erikvanzijst/handheld/README.md

# 8-bit handheld multiplayer gaming device

An Open Source Hardware custom designed handheld gaming device.

* powered by an 8-bit AVR XMEGA microcontroller
* ultra low-res 24x16 monochrome display made of discrete LEDS
* authentic 8-bit retro sound and music
* EEPROM-based hiscores
* multiplayer over bidirectional infrared communication
* battery or USB powered

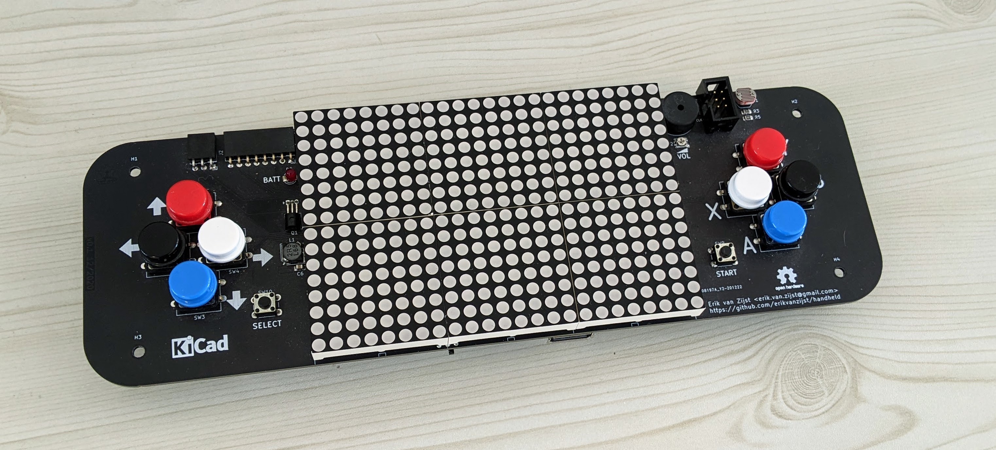
[picture p1: media/device.jpg]
Device


Project write-up at: https://medium.com/@erikvanzijst/diy-8-bit-handheld-multiplayer-gaming-device-cc30baae7372

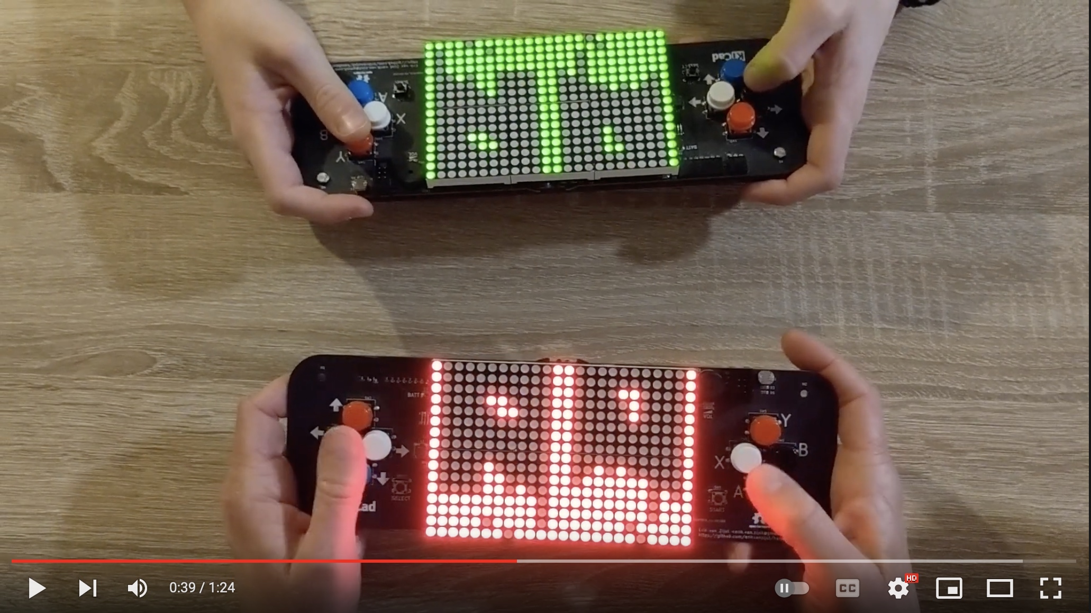
[picture p2: media/yt_thumbnail.jpg]
Multiplayer Tetris video (https://www.youtube.com/watch?v=yx9ZlABf7WM "Watch on Youtube")
