erikvanzijst/handheld/media/kicad_render2.png

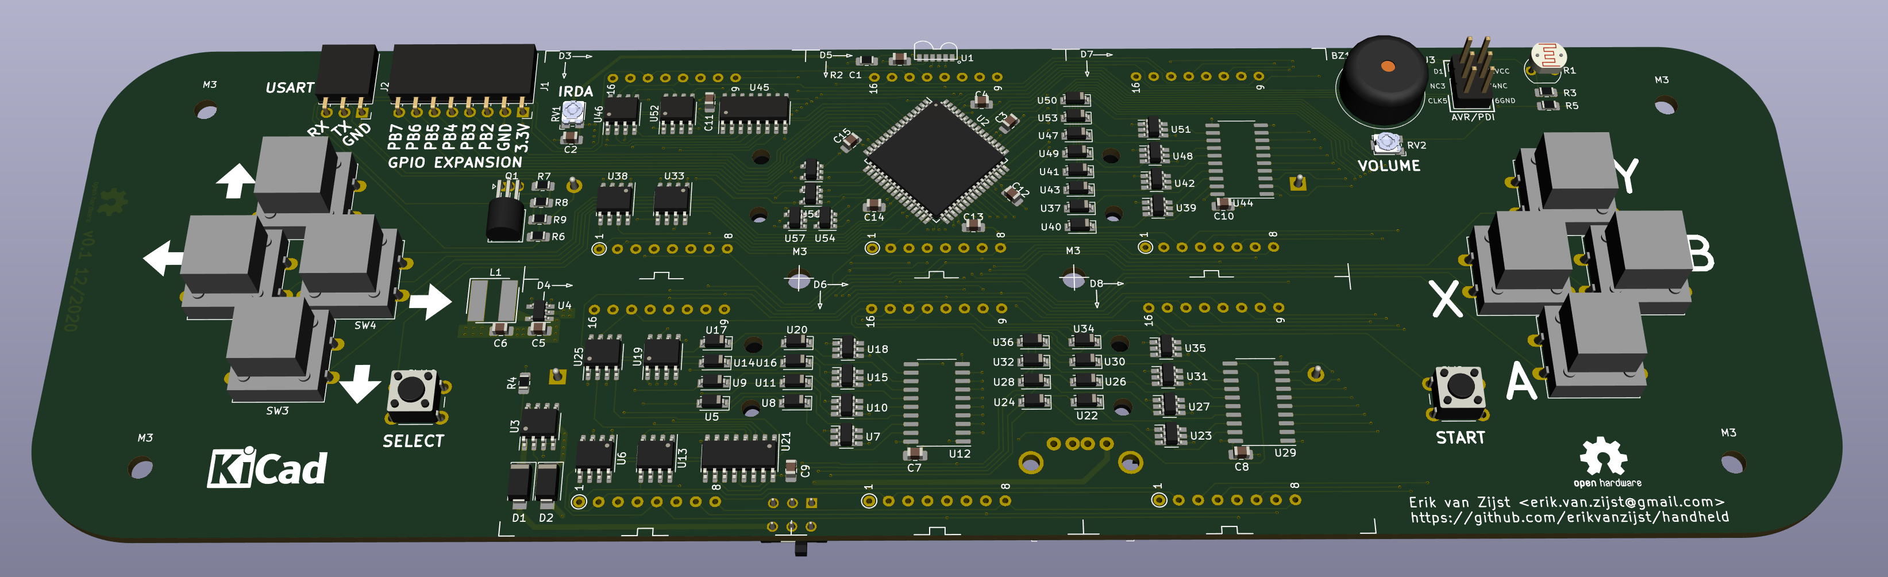
media/kicad_render2.png
