erikvanzijst/handheld/media/layout1.jpg

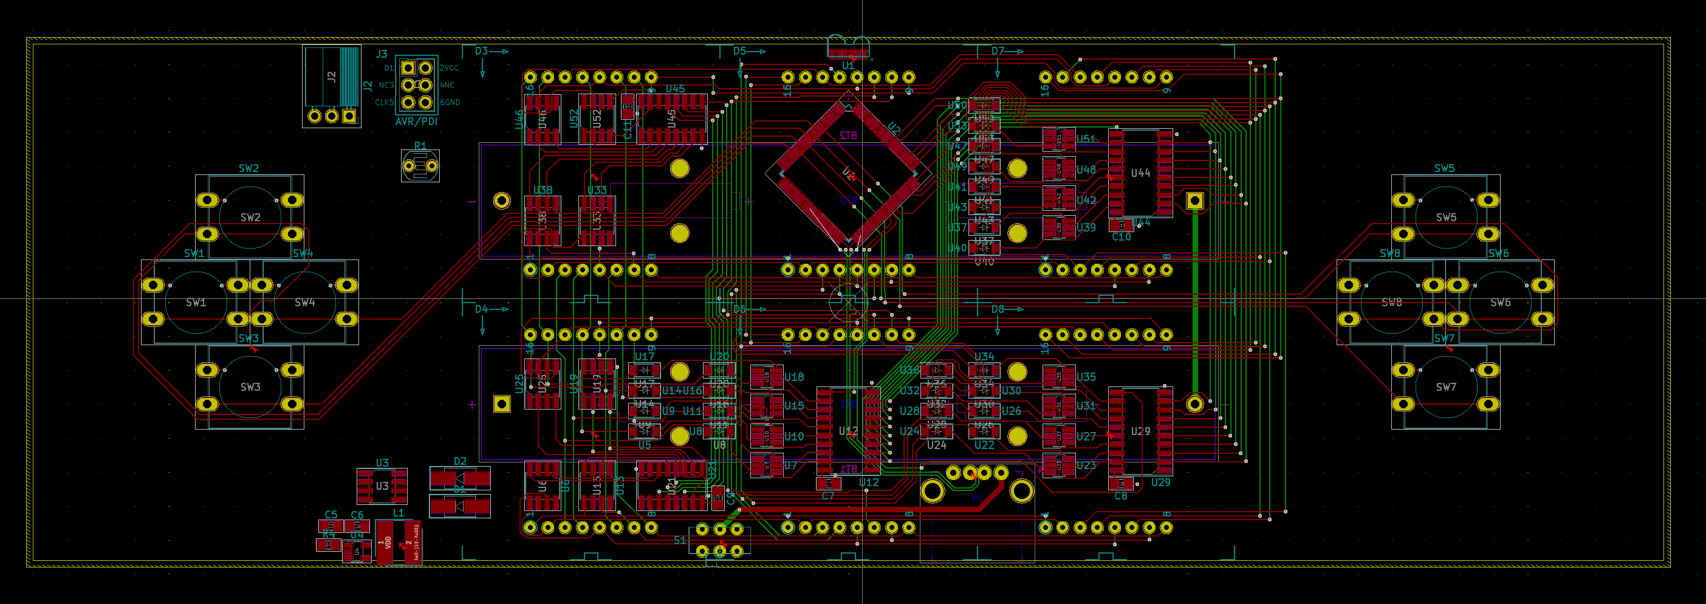
media/layout1.jpg
