erikvanzijst/handheld/media/pulseview_irda.png

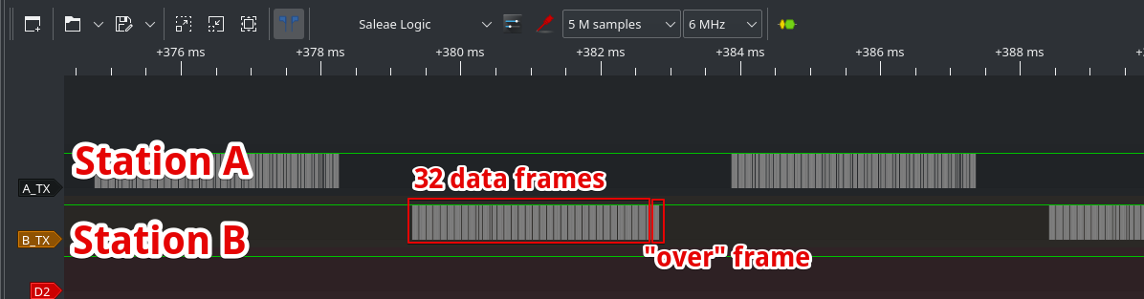
media/pulseview_irda.png
