erikvanzijst/handheld/media/shield1.png

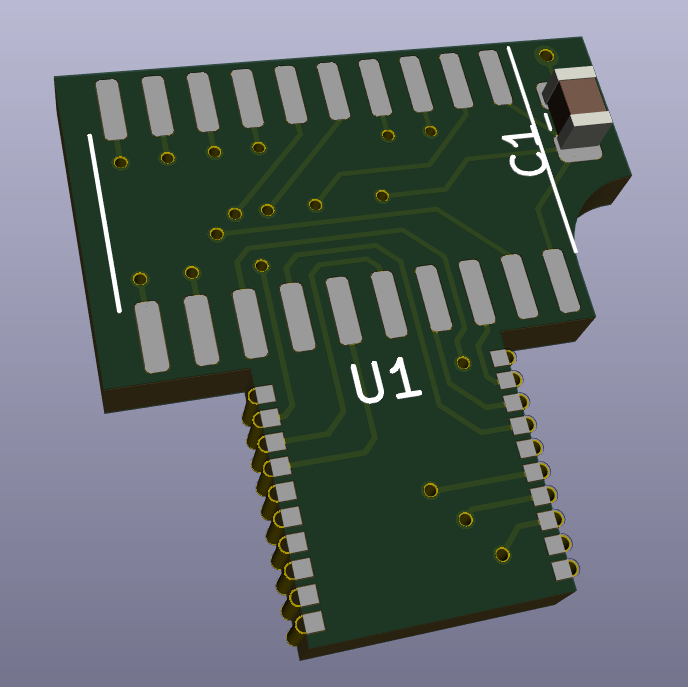
media/shield1.png
