erikvanzijst/handheld/media/short_circuit.jpg

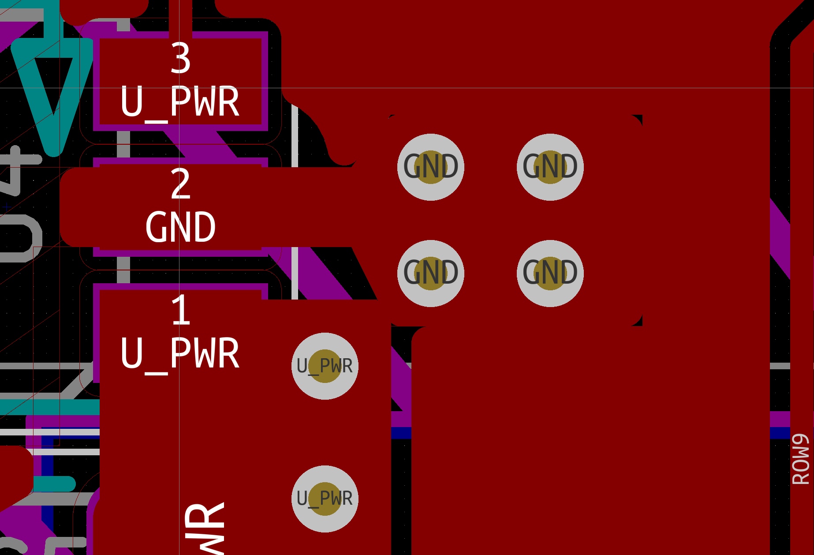
media/short_circuit.jpg
