erikvanzijst/handheld/media/short_circuit_drc.jpg

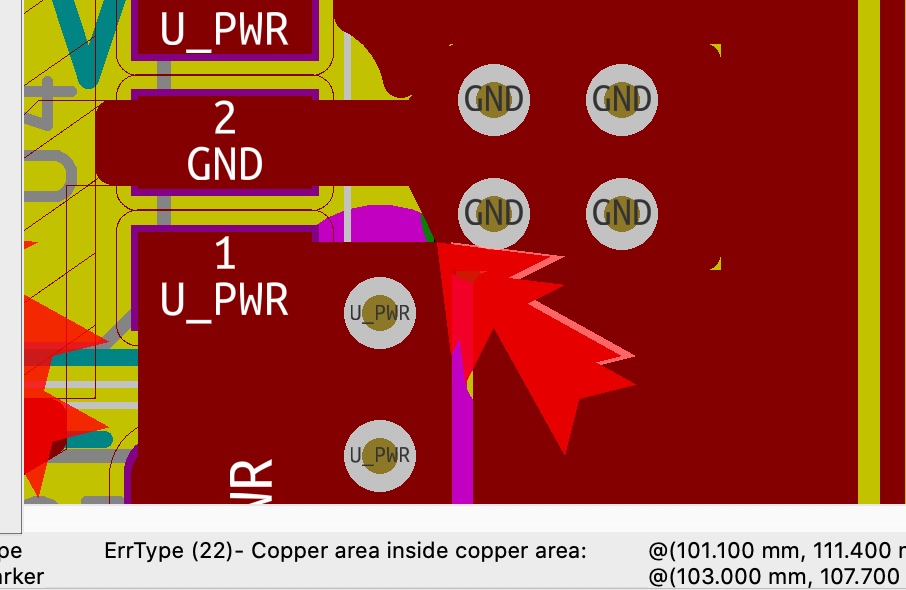
media/short_circuit_drc.jpg
