erikvanzijst/handheld/media/uart_send_loop.jpg

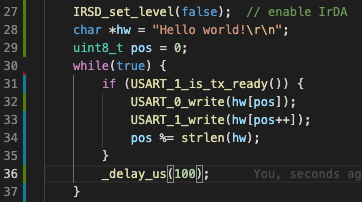
media/uart_send_loop.jpg
