erikvanzijst/handheld/media/uint64_division_asm.png

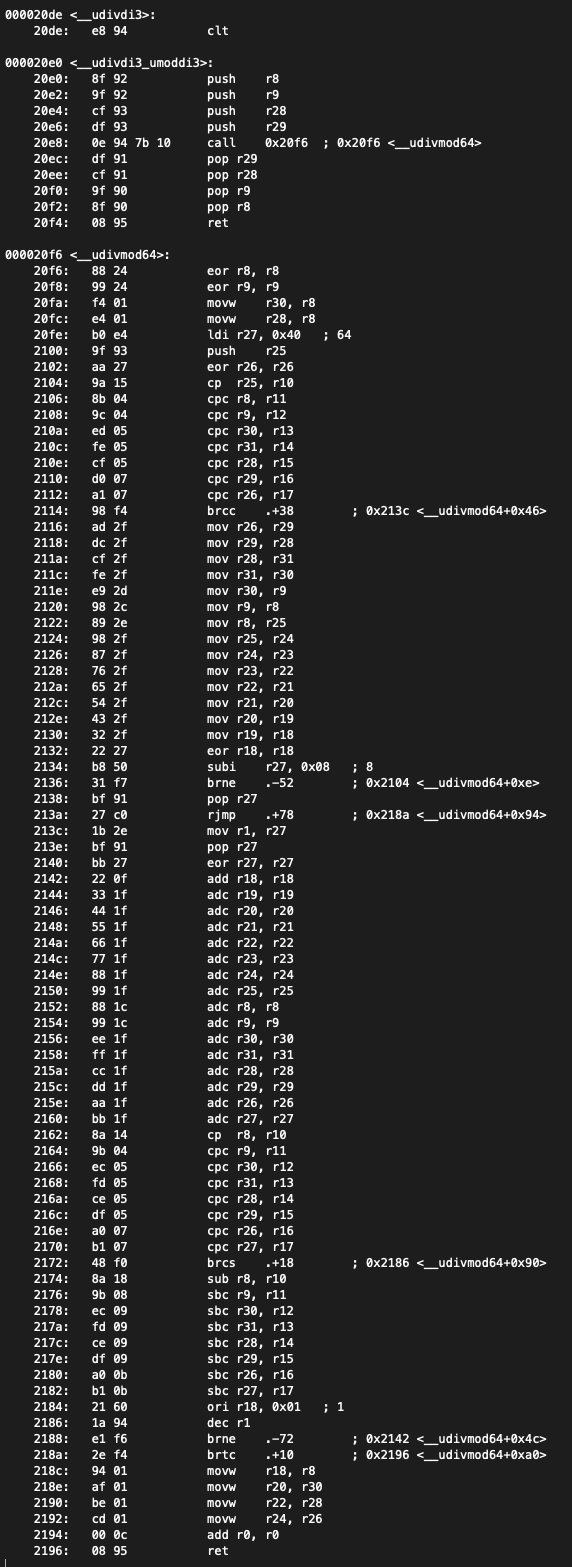
media/uint64_division_asm.png
