erikvanzijst/handheld/media/xmega_ircom.png

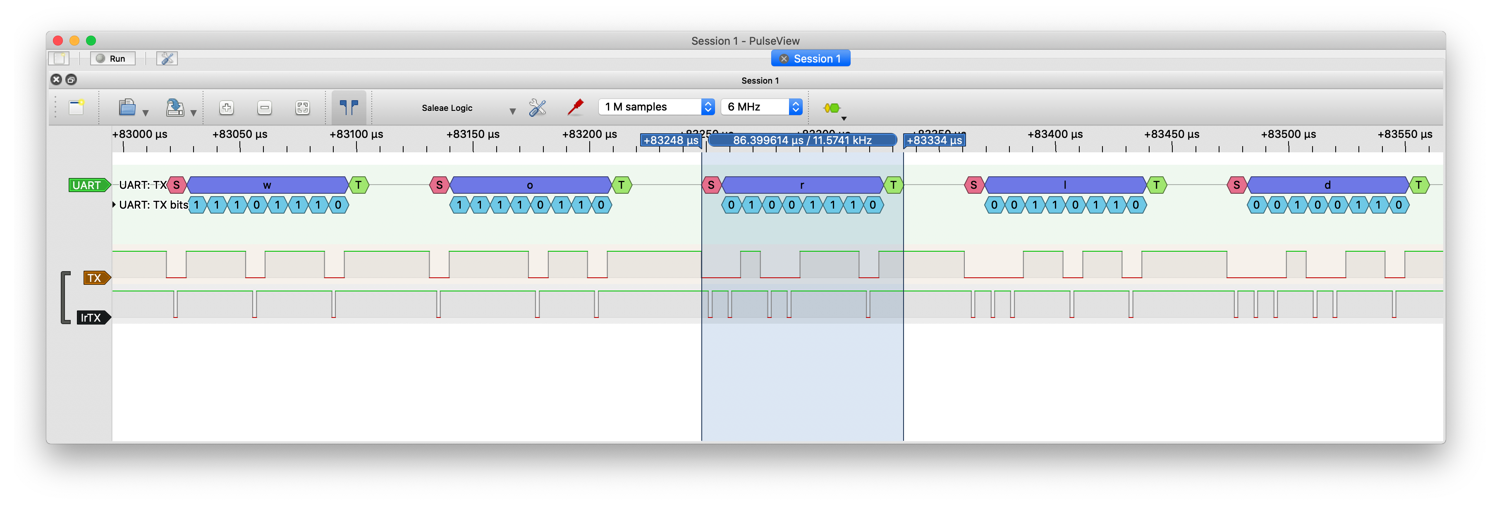
media/xmega_ircom.png
