erikvanzijst/handheld/kicad/TC33X-2-202E--3DModel-STEP-56544.step

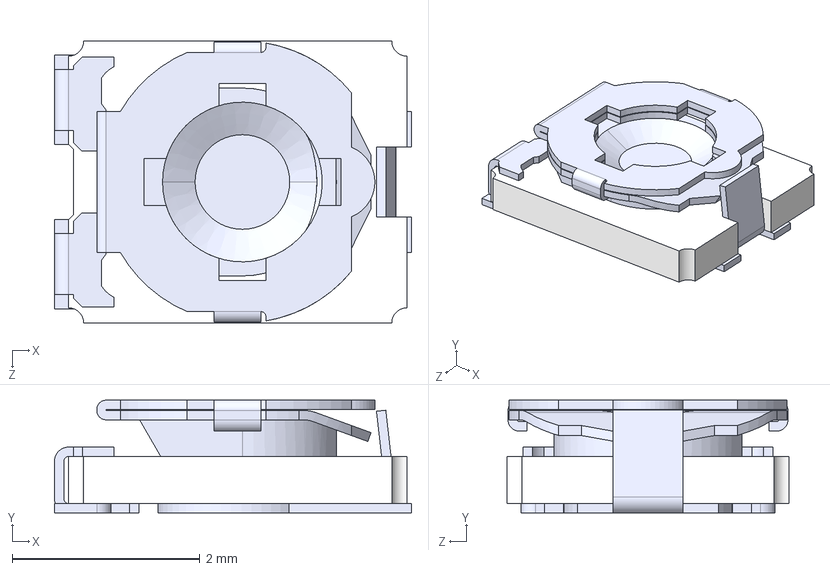
[picture p27: CAD file, 2020-11-29]
kicad/TC33X-2-202E--3DModel-STEP-56544.step
3.80 x 1.20 x 3.00 mm
