erikvanzijst/handheld/kicad/B3F-4055--3DModel-STEP-273799.STEP

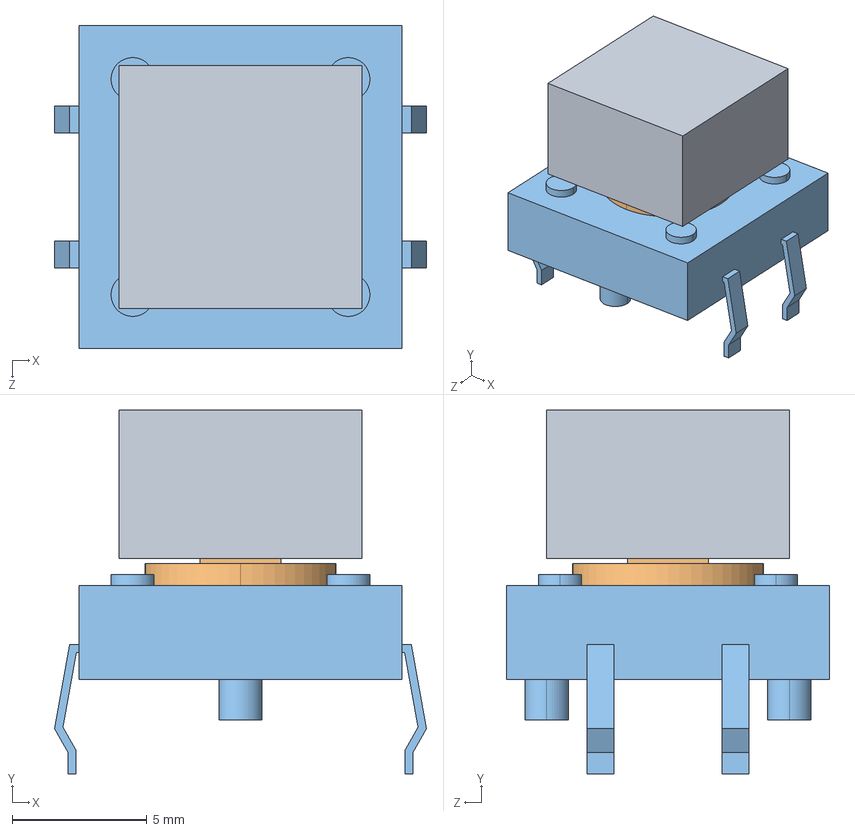
[picture p28: CAD file, 2020-11-28]
kicad/B3F-4055--3DModel-STEP-273799.STEP
13.8 x 13.5 x 12.0 mm
B32_1200
B3F_4055_BUTTON
B3F_4055_BASE
