erikvanzijst/handheld/kicad/TC-33X-2.stp

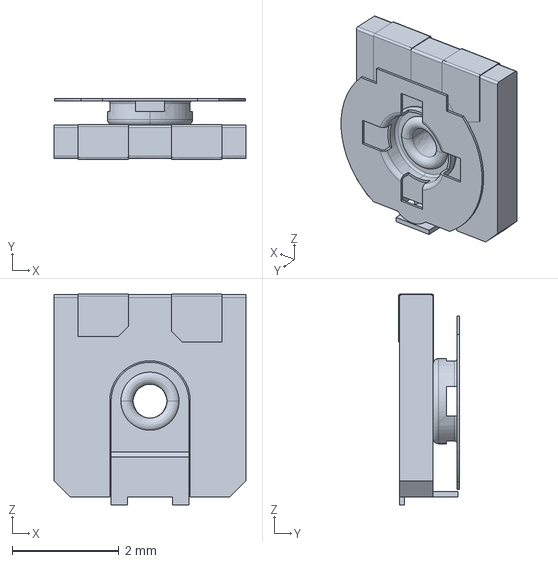
[picture p29: CAD file, 2020-10-12]
kicad/TC-33X-2.stp
3.60 x 1.15 x 3.96 mm
