erikvanzijst/handheld/kicad/84406TFBS4711.stp

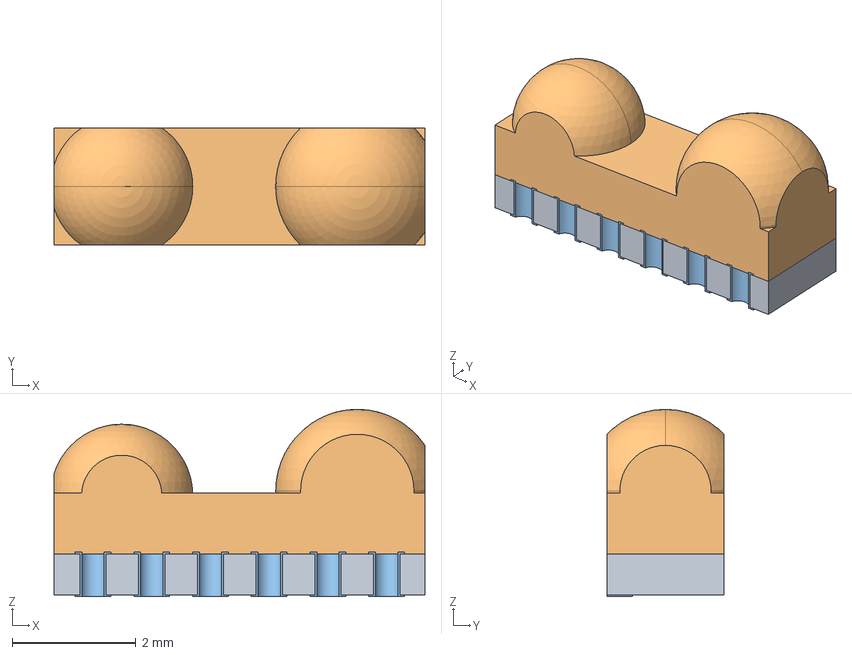
[picture p30: CAD file, 2020-10-13]
kicad/84406TFBS4711.stp
6.00 x 1.90 x 3.03 mm
PLATINE
GEHAEUSE
KONTAKT x 6
