erikvanzijst/handheld/media/irda_logic_analyzer_testing.jpg

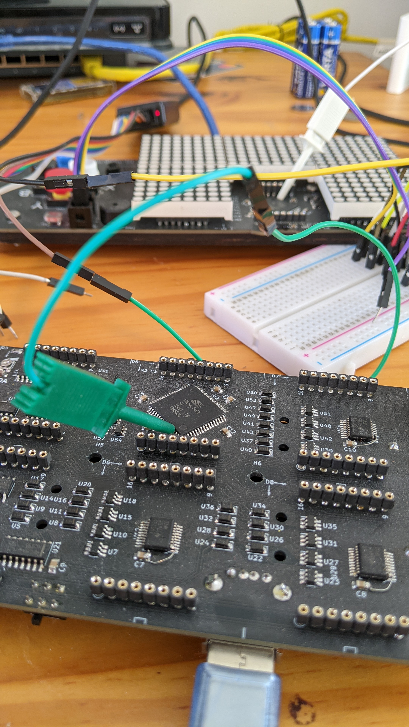
media/irda_logic_analyzer_testing.jpg
