erikvanzijst/handheld/media/irda_uart_testing.png

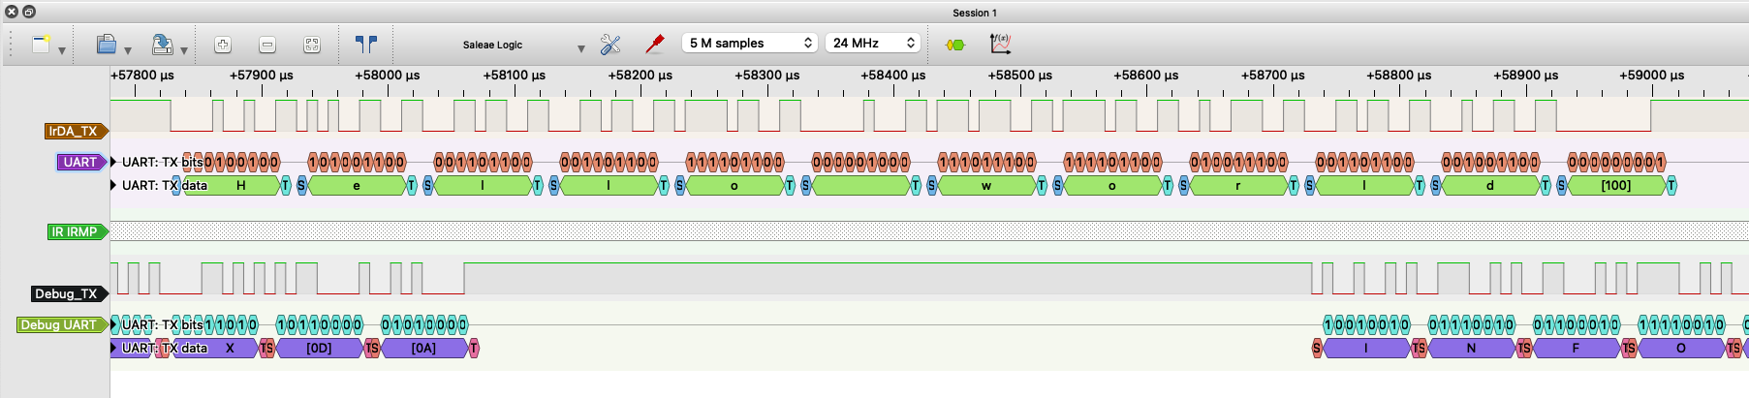
media/irda_uart_testing.png
