erikvanzijst/handheld/kicad/handheld.kicad_pcb

## KiCad design kicad/handheld.kicad_pcb (2021-01-19)

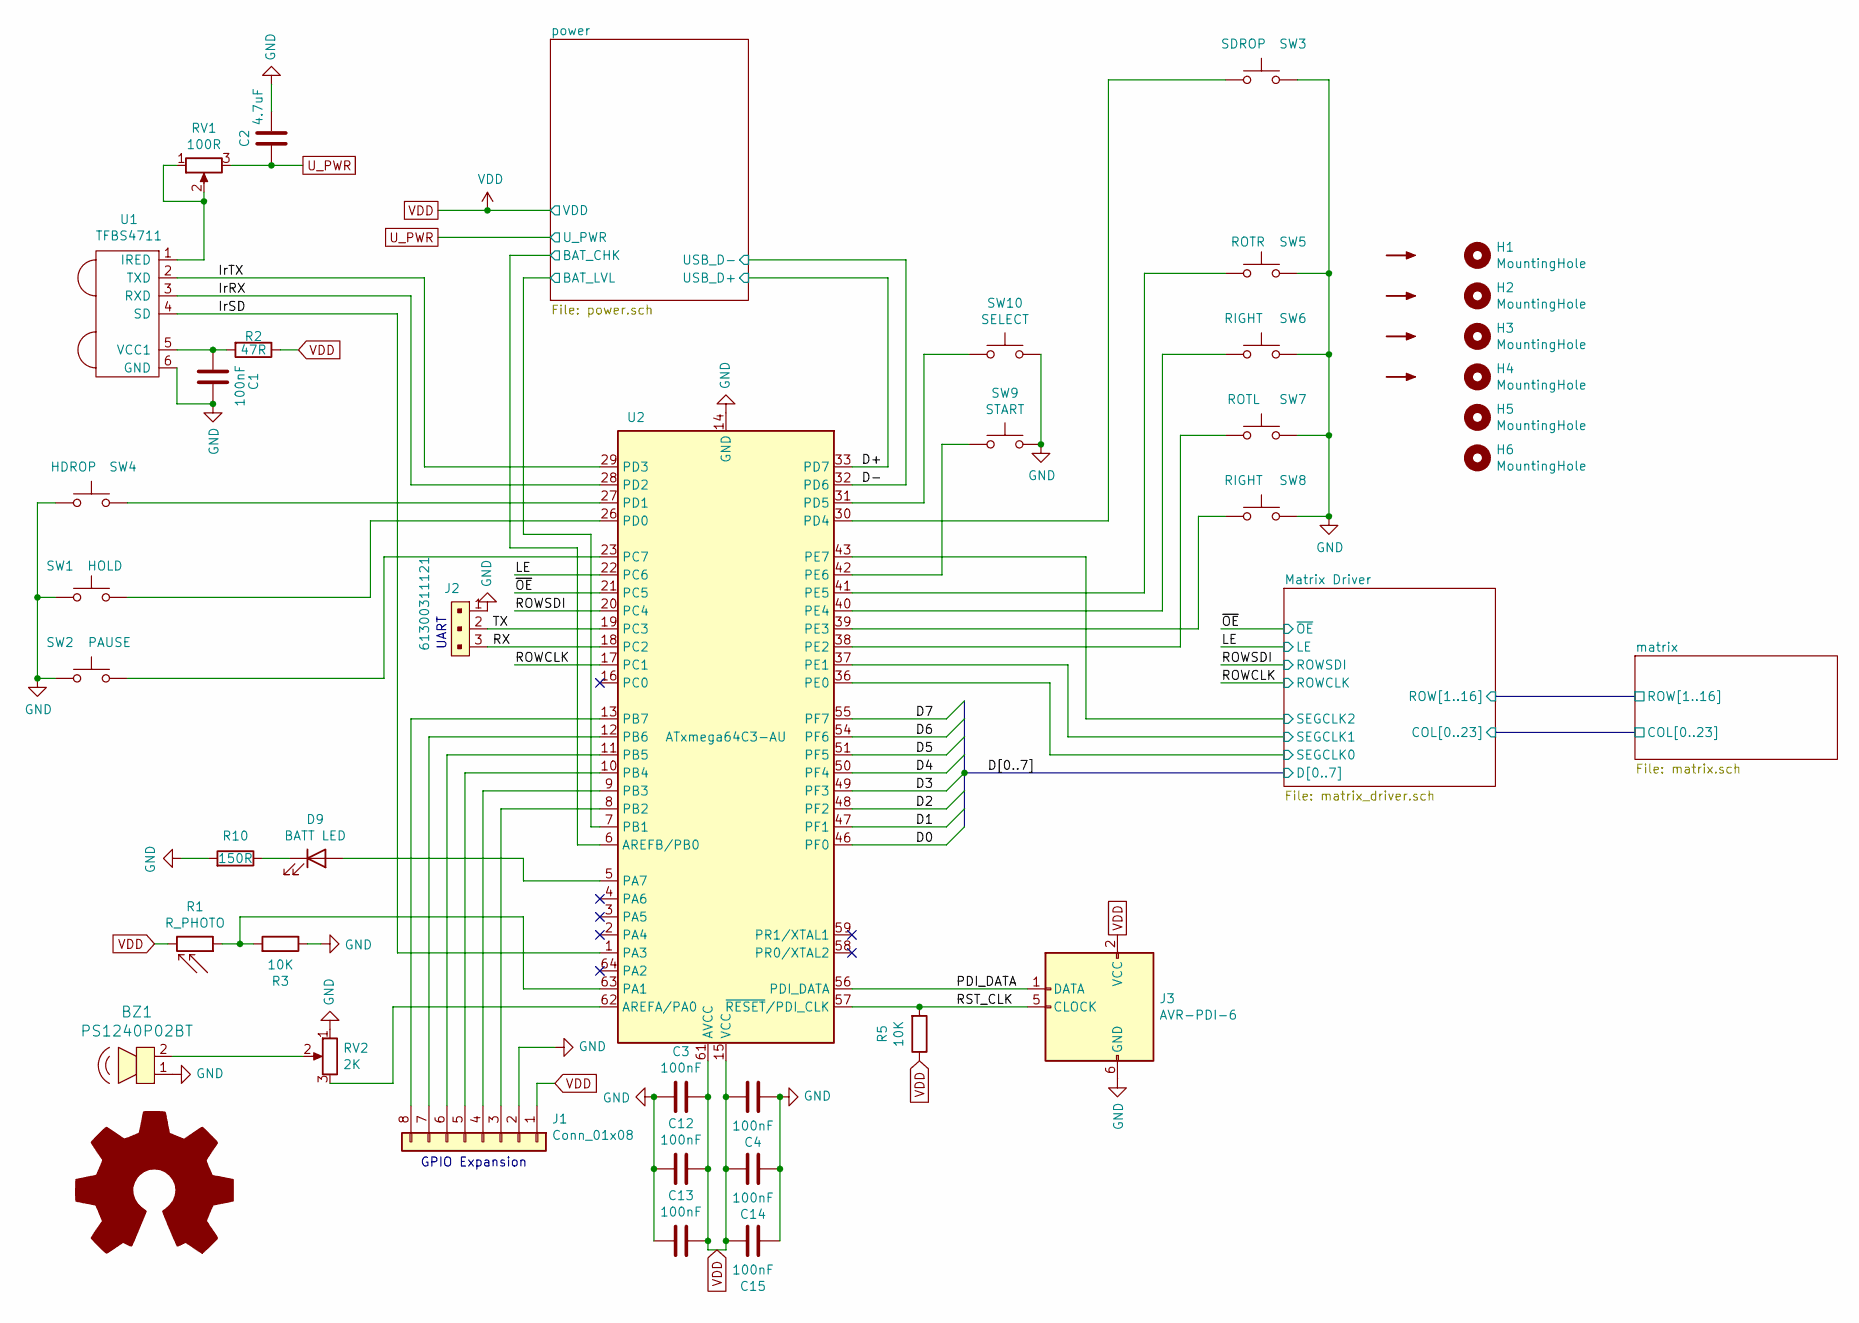
[picture p39: schematic handheld.sch, Handheld gaming device]

Parts:
BZ1: PS1240P02BT; Piezo_Transducer_THT_PS1240P02BT; MPN PS1240P02BT; Digi-Key_PN 445-2525-1-ND
C1, C3, C4, C12, C13, C14, C15: 100nF; C_0805_2012Metric_Pad1.15x1.40mm_HandSolder
C2: 4.7uF; C_0805_2012Metric_Pad1.15x1.40mm_HandSolder
D9: BATT LED; LED_D3.0mm
H1, H2, H3, H4, H5, H6: MountingHole; MountingHole_3.2mm_M3
J1: Conn_01x08; PinSocket_1x08_P2.54mm_Horizontal
J2: 61300311121; PinSocket_1x03_P2.54mm_Horizontal; MPN 61300311121; Digi-Key_PN 732-5316-ND
J3: AVR-PDI-6; AVR_PDI_Header_2x03_P2.54mm_Vertical
R1: R_PHOTO; R_LDR_5.1x4.3mm_P3.4mm_Vertical
R2: 47R; R_0805_2012Metric_Pad1.15x1.40mm_HandSolder
R3, R5: 10K; R_0805_2012Metric_Pad1.15x1.40mm_HandSolder
R10: 150R; R_0805_2012Metric_Pad1.15x1.40mm_HandSolder
RV1: 100R; Potentiometer_Bourns_TC33X_Vertical
RV2: 2K; Potentiometer_Bourns_TC33X_Vertical
SW1: HOLD; SW_PUSH-12mm
SW2: PAUSE; SW_PUSH-12mm
SW3: SDROP; SW_PUSH-12mm
SW4: HDROP; SW_PUSH-12mm
SW5: ROTR; SW_PUSH-12mm
SW6, SW8: RIGHT; SW_PUSH-12mm
SW7: ROTL; SW_PUSH-12mm
SW9: START; SW_PUSH_6mm
SW10: SELECT; SW_PUSH_6mm
U1: TFBS4711; TFBS4711-IrDA
U2: ATxmega64C3-AU; TQFP-64_14x14mm_P0.8mm

Connections:
/D0: U2.46 (PF0); also elsewhere on the board
/D1: U2.47 (PF1); also elsewhere on the board
/D2: U2.48 (PF2); also elsewhere on the board
/D3: U2.49 (PF3); also elsewhere on the board
/D4: U2.50 (PF4); also elsewhere on the board
/D5: U2.51 (PF5); also elsewhere on the board
/D6: U2.54 (PF6); also elsewhere on the board
/D7: U2.55 (PF7); also elsewhere on the board
/D+: U2.33 (PD7); also elsewhere on the board
/D-: U2.32 (PD6); also elsewhere on the board
/IrRX: U1.3 (RXD), U2.28 (PD2)
/IrSD: U1.4 (SD), U2.1 (PA3)
/IrTX: U1.2 (TXD), U2.29 (PD3)
/LE: U2.22 (PC6); also elsewhere on the board
/Matrix Driver/SEGCLK0: U2.36 (PE0); also elsewhere on the board
/Matrix Driver/SEGCLK1: U2.37 (PE1); also elsewhere on the board
/Matrix Driver/SEGCLK2: U2.43 (PE7); also elsewhere on the board
/PDI_DATA: J3.1 (DATA), U2.56 (PDI_DATA)
/ROWCLK: U2.17 (PC1); also elsewhere on the board
/ROWSDI: U2.20 (PC4); also elsewhere on the board
/RST_CLK: J3.5 (CLOCK), R5.2, U2.57 (~RESET~/PDI_CLK)
/RX: J2.3, U2.18 (PC2)
/TX: J2.2, U2.19 (PC3)
/power/BAT_CHK: U2.6 (AREFB/PB0); also elsewhere on the board
/power/BAT_LVL: U2.7 (PB1); also elsewhere on the board
/~OE: U2.21 (PC5); also elsewhere on the board
GND: BZ1.1, C1.1, C2.2, C3.2, C4.2, C12.2, C13.2, C14.2, C15.2, J1.2, J2.1, J3.6 (GND), R3.1, R10.2, RV2.1, SW1.1, SW2.1, SW3.1, SW4.2, SW5.1, SW6.1, SW7.1, SW8.1, SW9.2, SW10.2, U1.6 (GND), U2.14 (GND), U2.24 (GND), U2.34 (GND), U2.44 (GND), U2.52 (GND), U2.60 (GND); also elsewhere on the board
unnamed: BZ1.2, RV2.2
unnamed: C1.2, R2.2, U1.5 (VCC1)
unnamed: D9.1 (K), R10.1
unnamed: D9.2 (A), U2.5 (PA7)
unnamed: J1.3, U2.8 (PB2)
unnamed: J1.4, U2.9 (PB3)
unnamed: J1.5, U2.10 (PB4)
unnamed: J1.6, U2.11 (PB5)
unnamed: J1.7, U2.12 (PB6)
unnamed: J1.8, U2.13 (PB7)
unnamed: R1.1, R3.2, U2.63 (PA1)
unnamed: RV1.1, RV1.2, U1.1 (IRED)
unnamed: RV2.3, U2.62 (AREFA/PA0)
unnamed: SW1.2, U2.26 (PD0)
unnamed: SW2.2, U2.23 (PC7)
unnamed: SW3.2, U2.30 (PD4)
unnamed: SW4.1, U2.27 (PD1)
unnamed: SW5.2, U2.41 (PE5)
unnamed: SW6.2, U2.40 (PE4)
unnamed: SW7.2, U2.38 (PE2)
unnamed: SW8.2, U2.39 (PE3)
unnamed: SW9.1, U2.42 (PE6)
unnamed: SW10.1, U2.31 (PD5)
U_PWR: C2.1, RV1.3; also elsewhere on the board
VDD: C3.1, C4.1, C12.1, C13.1, C14.1, C15.1, J1.1, J3.2 (VCC), R1.2, R2.1, R5.1, U2.15 (VCC), U2.25 (VCC), U2.35 (VCC), U2.45 (VCC), U2.53 (VCC), U2.61 (AVCC); also elsewhere on the board

Notes on the sheet:
UART
GPIO Expansion

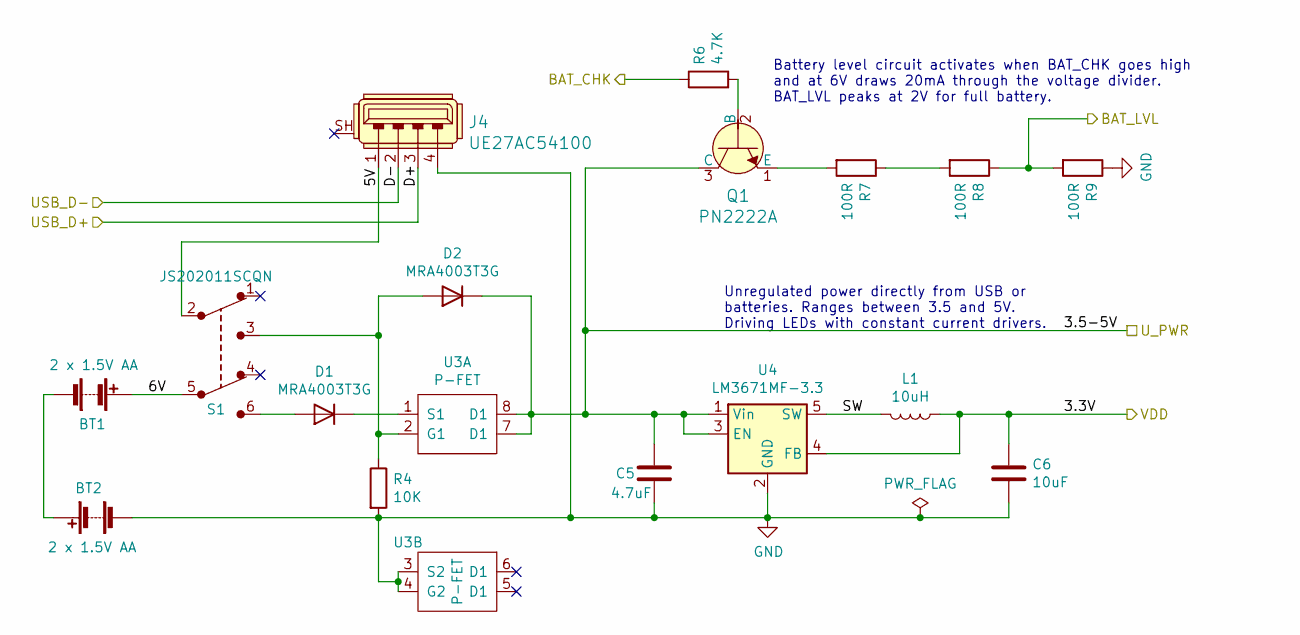
[picture p40: schematic power.sch]

Parts:
BT1, BT2: 2 x 1.5V AA; BatteryHolder_MPD_BC12AAPC_2xAA
C5: 4.7uF; C_0805_2012Metric_Pad1.15x1.40mm_HandSolder
C6: 10uF; C_0805_2012Metric_Pad1.15x1.40mm_HandSolder
D1, D2: MRA4003T3G; D_SMA
J4: UE27AC54100; USB_A_Female_UE27AC54100; MPN UE27AC54100; Digi-Key_PN UE27AC54100-ND
L1: 10uH; CDRH5D18NP
Q1: PN2222A; TO-92_Inline_W4.0mm_Horizontal_FlatSideDown; MPN PN2222A; Digi-Key_PN PN2222ACS-ND
R4: 10K; R_0805_2012Metric_Pad1.15x1.40mm_HandSolder
R6: 4.7K; R_0805_2012Metric_Pad1.15x1.40mm_HandSolder
R7, R8, R9: 100R; R_0805_2012Metric_Pad1.15x1.40mm_HandSolder
S1: JS202011SCQN; SW_CuK_JS202011AQN_DPDT_Angled; MPN JS202011SCQN; Digi-Key_PN 401-2002-1-ND
U3: P-FET; SOIC-8_3.9x4.9mm_P1.27mm
U4: LM3671MF-3.3; TSOT-23-5

Connections:
/D+: J4.3; also elsewhere on the board
/D-: J4.2; also elsewhere on the board
/power/5V: J4.1, S1.2
/power/6V: BT1.1 (+), S1.5
/power/BAT_CHK: R6.1; also elsewhere on the board
/power/BAT_LVL: R8.1, R9.2; also elsewhere on the board
/power/SW: L1.2, U4.5 (SW)
GND: BT2.2 (-), C5.2, C6.2, J4.4, R4.2, R9.1, U3.3 (S2), U3.4 (G2), U4.2 (GND); also elsewhere on the board
unnamed: BT1.2 (-), BT2.1 (+)
unnamed: D1.1 (K), U3.1 (S1)
unnamed: D1.2 (A), S1.6
unnamed: D2.2 (A), R4.1, S1.3, U3.2 (G1)
unnamed: Q1.1 (E), R7.2
unnamed: Q1.2 (B), R6.2
unnamed: R7.1, R8.2
U_PWR: C5.1, D2.1 (K), Q1.3 (C), U3.7 (D1), U3.8 (D1), U4.1 (Vin), U4.3 (EN); also elsewhere on the board
VDD: C6.1, L1.1, U4.4 (FB); also elsewhere on the board

Notes on the sheet:
Unregulated power directly from USB or batteries. Ranges between 3.5 and 5V. Driving LEDs with constant current drivers.
Battery level circuit activates when BAT_CHK goes high and at 6V draws 20mA through the voltage divider. BAT_LVL peaks at 2V for full battery.

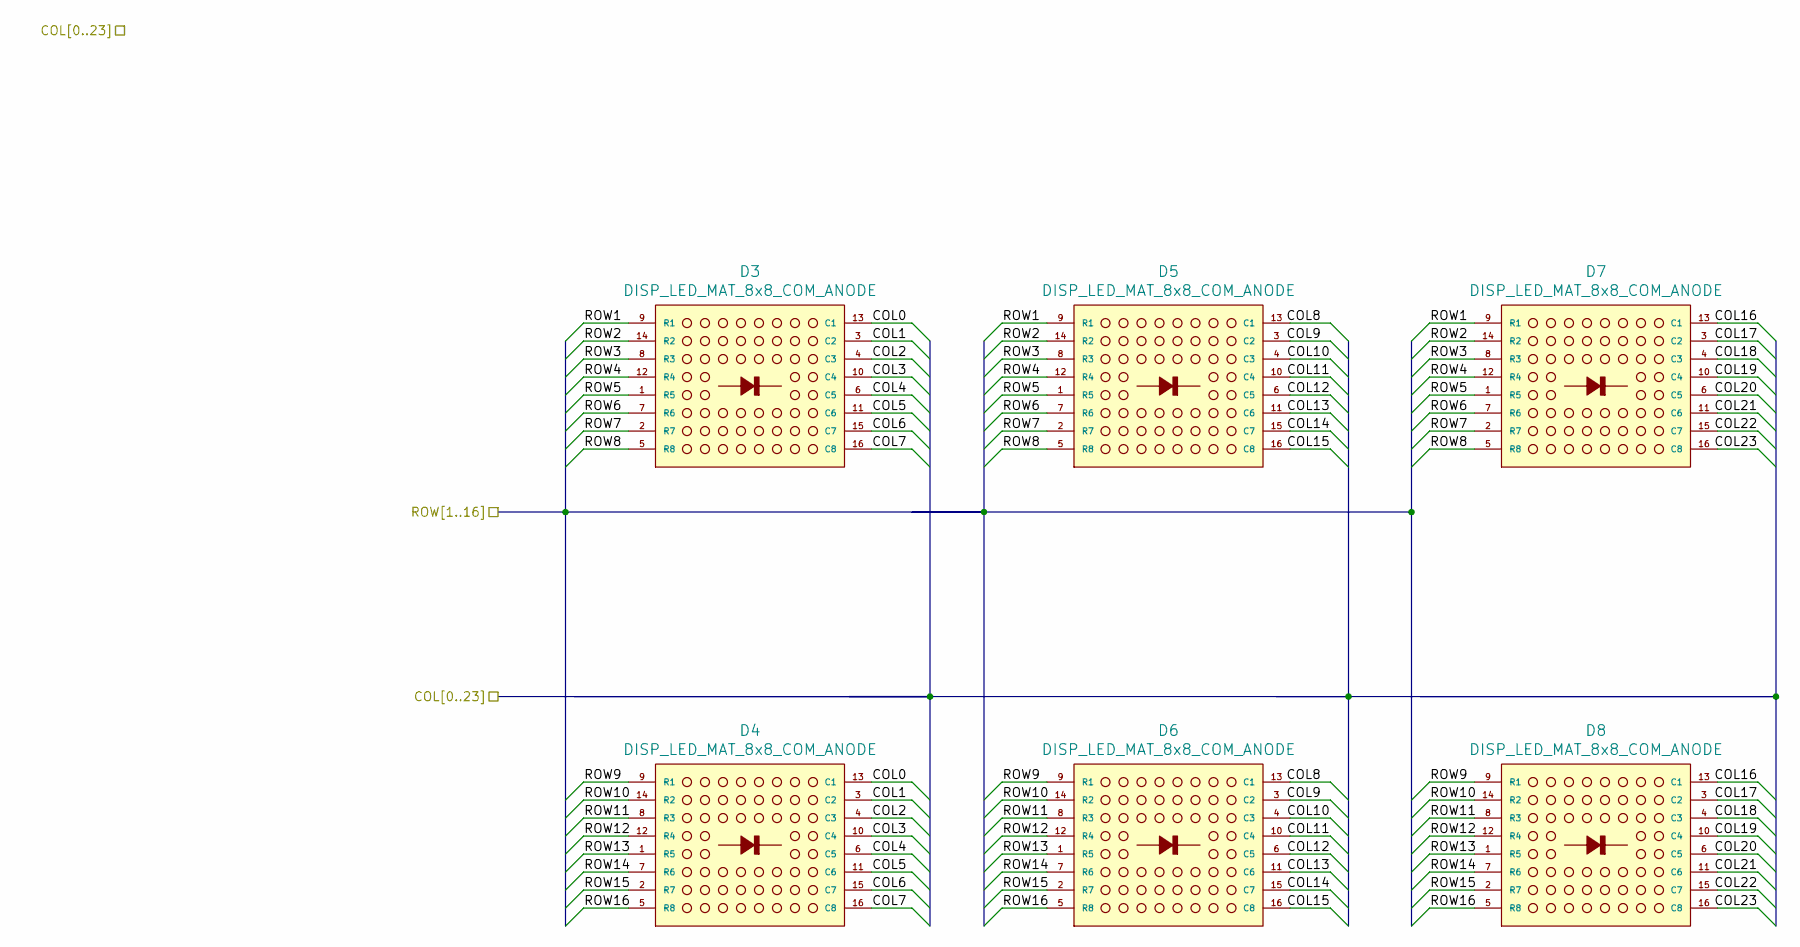
[picture p41: schematic matrix.sch]

Parts:
D3, D4, D5, D6, D7, D8: DISP_LED_MAT_8x8_COM_ANODE; LED_8x8_3MM_38x38MM

Connections:
/Matrix Driver/COL0: D3.13 (C1), D4.13 (C1); also elsewhere on the board
/Matrix Driver/COL1: D3.3 (C2), D4.3 (C2); also elsewhere on the board
/Matrix Driver/COL2: D3.4 (C3), D4.4 (C3); also elsewhere on the board
/Matrix Driver/COL3: D3.10 (C4), D4.10 (C4); also elsewhere on the board
/Matrix Driver/COL4: D3.6 (C5), D4.6 (C5); also elsewhere on the board
/Matrix Driver/COL5: D3.11 (C6), D4.11 (C6); also elsewhere on the board
/Matrix Driver/COL6: D3.15 (C7), D4.15 (C7); also elsewhere on the board
/Matrix Driver/COL7: D3.16 (C8), D4.16 (C8); also elsewhere on the board
/Matrix Driver/COL8: D5.13 (C1), D6.13 (C1); also elsewhere on the board
/Matrix Driver/COL9: D5.3 (C2), D6.3 (C2); also elsewhere on the board
/Matrix Driver/COL10: D5.4 (C3), D6.4 (C3); also elsewhere on the board
/Matrix Driver/COL11: D5.10 (C4), D6.10 (C4); also elsewhere on the board
/Matrix Driver/COL12: D5.6 (C5), D6.6 (C5); also elsewhere on the board
/Matrix Driver/COL13: D5.11 (C6), D6.11 (C6); also elsewhere on the board
/Matrix Driver/COL14: D5.15 (C7), D6.15 (C7); also elsewhere on the board
/Matrix Driver/COL15: D5.16 (C8), D6.16 (C8); also elsewhere on the board
/Matrix Driver/COL16: D7.13 (C1), D8.13 (C1); also elsewhere on the board
/Matrix Driver/COL17: D7.3 (C2), D8.3 (C2); also elsewhere on the board
/Matrix Driver/COL18: D7.4 (C3), D8.4 (C3); also elsewhere on the board
/Matrix Driver/COL19: D7.10 (C4), D8.10 (C4); also elsewhere on the board
/Matrix Driver/COL20: D7.6 (C5), D8.6 (C5); also elsewhere on the board
/Matrix Driver/COL21: D7.11 (C6), D8.11 (C6); also elsewhere on the board
/Matrix Driver/COL22: D7.15 (C7), D8.15 (C7); also elsewhere on the board
/Matrix Driver/COL23: D7.16 (C8), D8.16 (C8); also elsewhere on the board
/Matrix Driver/ROW1: D3.9 (R1), D5.9 (R1), D7.9 (R1); also elsewhere on the board
/Matrix Driver/ROW2: D3.14 (R2), D5.14 (R2), D7.14 (R2); also elsewhere on the board
/Matrix Driver/ROW3: D3.8 (R3), D5.8 (R3), D7.8 (R3); also elsewhere on the board
/Matrix Driver/ROW4: D3.12 (R4), D5.12 (R4), D7.12 (R4); also elsewhere on the board
/Matrix Driver/ROW5: D3.1 (R5), D5.1 (R5), D7.1 (R5); also elsewhere on the board
/Matrix Driver/ROW6: D3.7 (R6), D5.7 (R6), D7.7 (R6); also elsewhere on the board
/Matrix Driver/ROW7: D3.2 (R7), D5.2 (R7), D7.2 (R7); also elsewhere on the board
/Matrix Driver/ROW8: D3.5 (R8), D5.5 (R8), D7.5 (R8); also elsewhere on the board
/Matrix Driver/ROW9: D4.9 (R1), D6.9 (R1), D8.9 (R1); also elsewhere on the board
/Matrix Driver/ROW10: D4.14 (R2), D6.14 (R2), D8.14 (R2); also elsewhere on the board
/Matrix Driver/ROW11: D4.8 (R3), D6.8 (R3), D8.8 (R3); also elsewhere on the board
/Matrix Driver/ROW12: D4.12 (R4), D6.12 (R4), D8.12 (R4); also elsewhere on the board
/Matrix Driver/ROW13: D4.1 (R5), D6.1 (R5), D8.1 (R5); also elsewhere on the board
/Matrix Driver/ROW14: D4.7 (R6), D6.7 (R6), D8.7 (R6); also elsewhere on the board
/Matrix Driver/ROW15: D4.2 (R7), D6.2 (R7), D8.2 (R7); also elsewhere on the board
/Matrix Driver/ROW16: D4.5 (R8), D6.5 (R8), D8.5 (R8); also elsewhere on the board

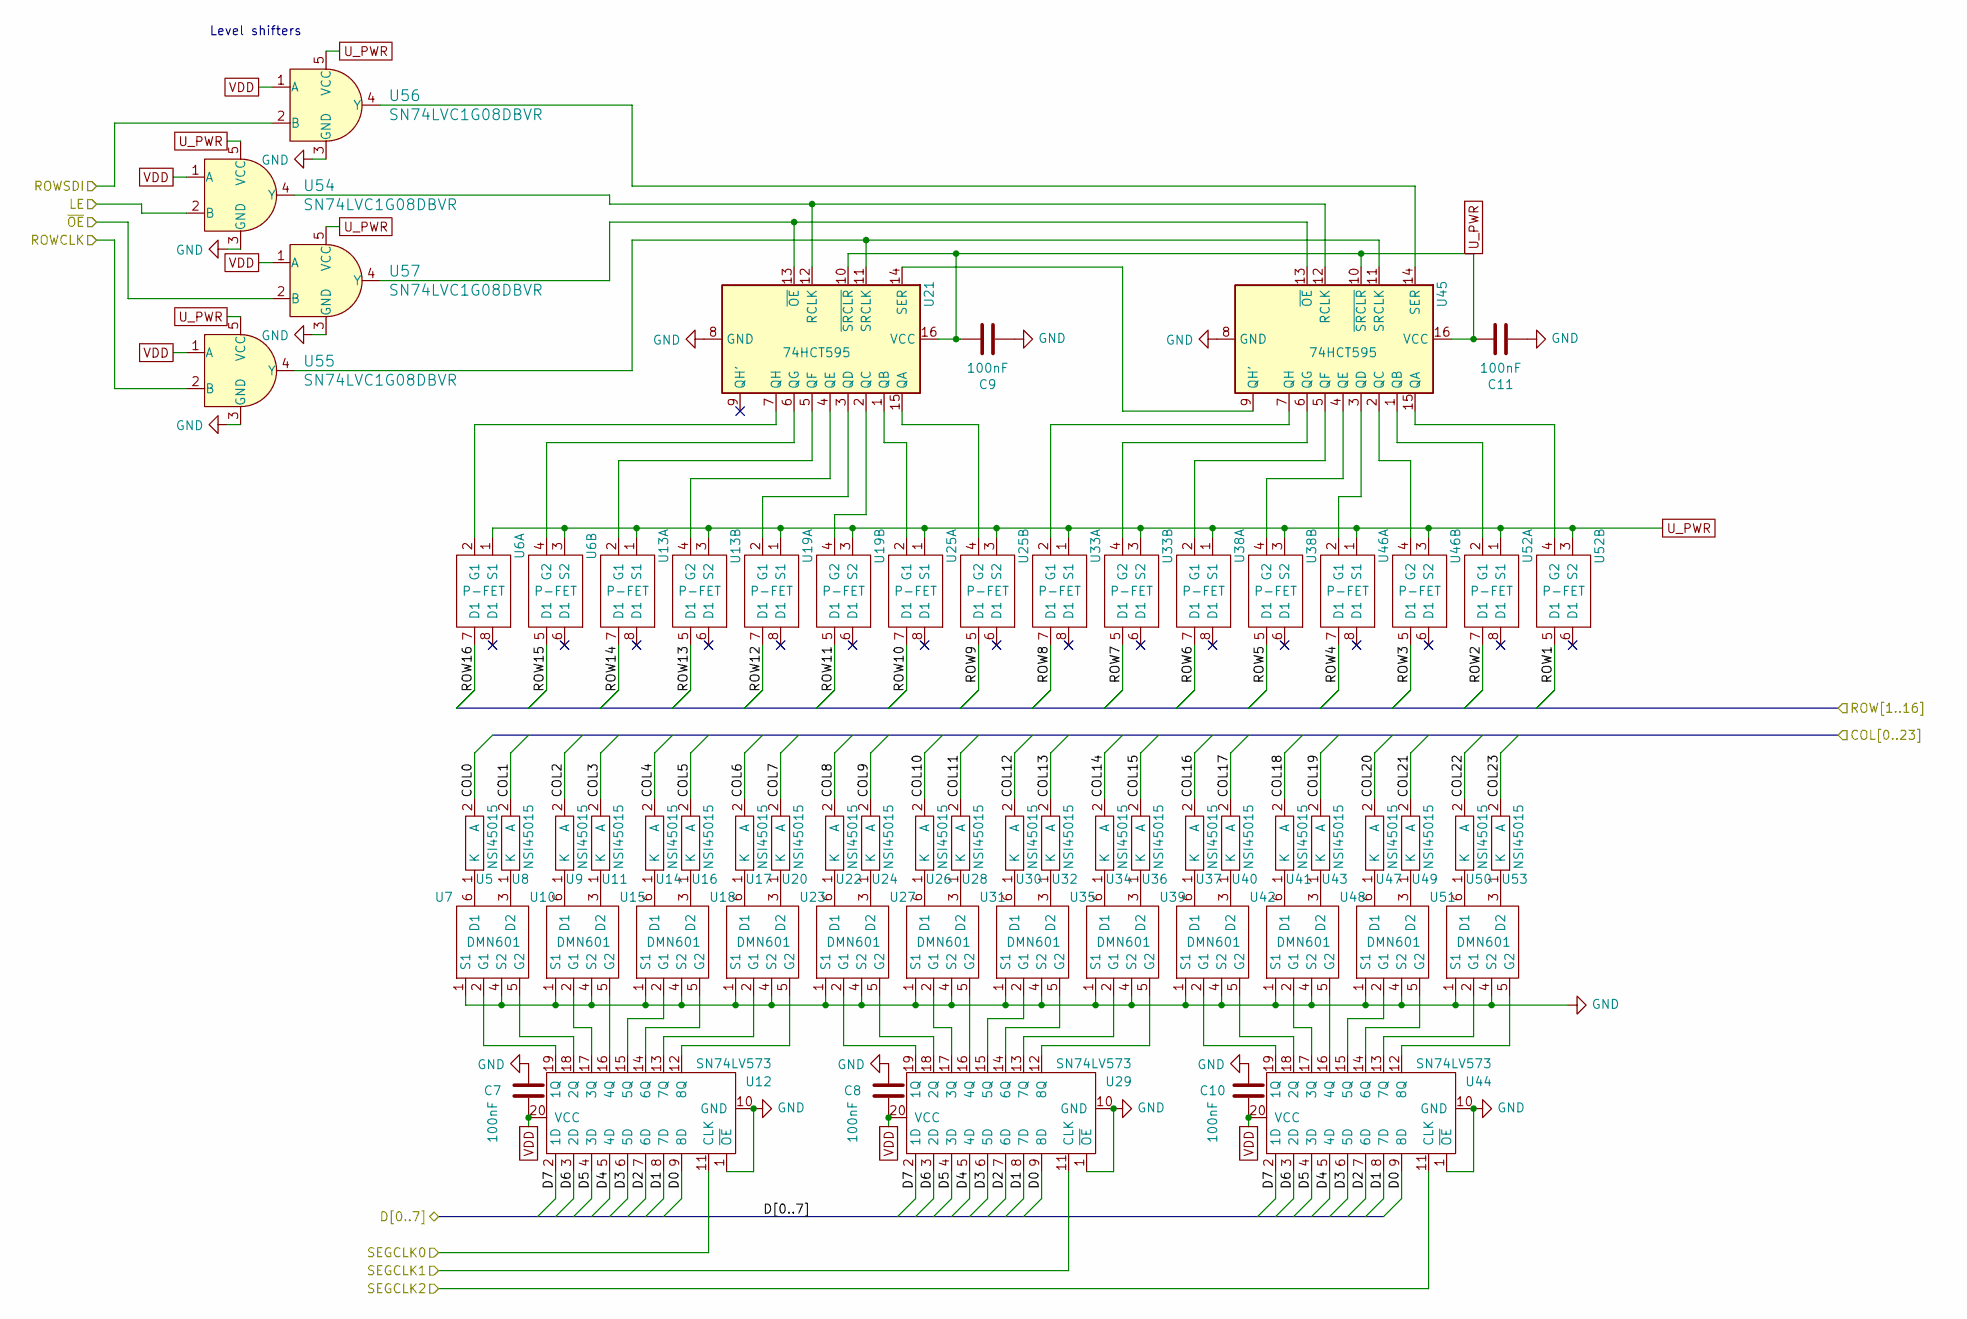
[picture p42: schematic matrix_driver.sch, Matrix driver circuit]

Parts:
C7, C8, C9, C10, C11: 100nF; C_0805_2012Metric_Pad1.15x1.40mm_HandSolder
U5, U8, U9, U11, U14, U16, U17, U20, U22, U24, U26, U28, U30, U32, U34, U36, U37, U40, U41, U43, U47, U49, U50, U53: NSI45015; D_SOD-123
U6, U13, U19, U25, U33, U38, U46, U52: P-FET; SOIC-8_3.9x4.9mm_P1.27mm
U7, U10, U15, U18, U23, U27, U31, U35, U39, U42, U48, U51: DMN601; SOT-23-6_Handsoldering
U12, U29, U44: SN74LV573; SO-20_5.3x12.6mm_P1.27mm
U21, U45: 74HCT595; SOIC-16_3.9x9.9mm_P1.27mm
U54, U55, U56, U57: SN74LVC1G08DBVR; SOT-23-5; MPN SN74LVC1G08DBVR; Digi-Key_PN 296-11601-1-ND

Connections:
/D0: U12.9 (8D), U29.9 (8D), U44.9 (8D); also elsewhere on the board
/D1: U12.8 (7D), U29.8 (7D), U44.8 (7D); also elsewhere on the board
/D2: U12.7 (6D), U29.7 (6D), U44.7 (6D); also elsewhere on the board
/D3: U12.6 (5D), U29.6 (5D), U44.6 (5D); also elsewhere on the board
/D4: U12.5 (4D), U29.5 (4D), U44.5 (4D); also elsewhere on the board
/D5: U12.4 (3D), U29.4 (3D), U44.4 (3D); also elsewhere on the board
/D6: U12.3 (2D), U29.3 (2D), U44.3 (2D); also elsewhere on the board
/D7: U12.2 (1D), U29.2 (1D), U44.2 (1D); also elsewhere on the board
/LE: U54.2 (B); also elsewhere on the board
/Matrix Driver/COL0: U5.2 (A); also elsewhere on the board
/Matrix Driver/COL1: U8.2 (A); also elsewhere on the board
/Matrix Driver/COL2: U9.2 (A); also elsewhere on the board
/Matrix Driver/COL3: U11.2 (A); also elsewhere on the board
/Matrix Driver/COL4: U14.2 (A); also elsewhere on the board
/Matrix Driver/COL5: U16.2 (A); also elsewhere on the board
/Matrix Driver/COL6: U17.2 (A); also elsewhere on the board
/Matrix Driver/COL7: U20.2 (A); also elsewhere on the board
/Matrix Driver/COL8: U22.2 (A); also elsewhere on the board
/Matrix Driver/COL9: U24.2 (A); also elsewhere on the board
/Matrix Driver/COL10: U26.2 (A); also elsewhere on the board
/Matrix Driver/COL11: U28.2 (A); also elsewhere on the board
/Matrix Driver/COL12: U30.2 (A); also elsewhere on the board
/Matrix Driver/COL13: U32.2 (A); also elsewhere on the board
/Matrix Driver/COL14: U34.2 (A); also elsewhere on the board
/Matrix Driver/COL15: U36.2 (A); also elsewhere on the board
/Matrix Driver/COL16: U37.2 (A); also elsewhere on the board
/Matrix Driver/COL17: U40.2 (A); also elsewhere on the board
/Matrix Driver/COL18: U41.2 (A); also elsewhere on the board
/Matrix Driver/COL19: U43.2 (A); also elsewhere on the board
/Matrix Driver/COL20: U47.2 (A); also elsewhere on the board
/Matrix Driver/COL21: U49.2 (A); also elsewhere on the board
/Matrix Driver/COL22: U50.2 (A); also elsewhere on the board
/Matrix Driver/COL23: U53.2 (A); also elsewhere on the board
/Matrix Driver/ROW1: U52.5 (D1); also elsewhere on the board
/Matrix Driver/ROW2: U52.7 (D1); also elsewhere on the board
/Matrix Driver/ROW3: U46.5 (D1); also elsewhere on the board
/Matrix Driver/ROW4: U46.7 (D1); also elsewhere on the board
/Matrix Driver/ROW5: U38.5 (D1); also elsewhere on the board
/Matrix Driver/ROW6: U38.7 (D1); also elsewhere on the board
/Matrix Driver/ROW7: U33.5 (D1); also elsewhere on the board
/Matrix Driver/ROW8: U33.7 (D1); also elsewhere on the board
/Matrix Driver/ROW9: U25.5 (D1); also elsewhere on the board
/Matrix Driver/ROW10: U25.7 (D1); also elsewhere on the board
/Matrix Driver/ROW11: U19.5 (D1); also elsewhere on the board
/Matrix Driver/ROW12: U19.7 (D1); also elsewhere on the board
/Matrix Driver/ROW13: U13.5 (D1); also elsewhere on the board
/Matrix Driver/ROW14: U13.7 (D1); also elsewhere on the board
/Matrix Driver/ROW15: U6.5 (D1); also elsewhere on the board
/Matrix Driver/ROW16: U6.7 (D1); also elsewhere on the board
/Matrix Driver/SEGCLK0: U12.11 (CLK); also elsewhere on the board
/Matrix Driver/SEGCLK1: U29.11 (CLK); also elsewhere on the board
/Matrix Driver/SEGCLK2: U44.11 (CLK); also elsewhere on the board
/ROWCLK: U55.2 (B); also elsewhere on the board
/ROWSDI: U56.2 (B); also elsewhere on the board
/~OE: U57.2 (B); also elsewhere on the board
GND: C7.1, C8.1, C9.2, C10.1, C11.2, U7.1 (S1), U7.4 (S2), U10.1 (S1), U10.4 (S2), U12.1 (~OE), U12.10 (GND), U15.1 (S1), U15.4 (S2), U18.1 (S1), U18.4 (S2), U21.8 (GND), U23.1 (S1), U23.4 (S2), U27.1 (S1), U27.4 (S2), U29.1 (~OE), U29.10 (GND), U31.1 (S1), U31.4 (S2), U35.1 (S1), U35.4 (S2), U39.1 (S1), U39.4 (S2), U42.1 (S1), U42.4 (S2), U44.1 (~OE), U44.10 (GND), U45.8 (GND), U48.1 (S1), U48.4 (S2), U51.1 (S1), U51.4 (S2), U54.3 (GND), U55.3 (GND), U56.3 (GND), U57.3 (GND); also elsewhere on the board
unnamed: U5.1 (K), U7.6 (D1)
unnamed: U7.3 (D2), U8.1 (K)
unnamed: U10.2 (G1), U12.17 (3Q)
unnamed: U10.3 (D2), U11.1 (K)
unnamed: U10.5 (G2), U12.16 (4Q)
unnamed: U9.1 (K), U10.6 (D1)
unnamed: U12.12 (8Q), U18.5 (G2)
unnamed: U12.13 (7Q), U18.2 (G1)
unnamed: U12.14 (6Q), U15.5 (G2)
unnamed: U12.15 (5Q), U15.2 (G1)
unnamed: U7.5 (G2), U12.18 (2Q)
unnamed: U7.2 (G1), U12.19 (1Q)
unnamed: U13.2 (G1), U21.5 (QF)
unnamed: U13.4 (G2), U21.4 (QE)
unnamed: U14.1 (K), U15.6 (D1)
unnamed: U15.3 (D2), U16.1 (K)
unnamed: U17.1 (K), U18.6 (D1)
unnamed: U18.3 (D2), U20.1 (K)
unnamed: U19.2 (G1), U21.3 (QD)
unnamed: U19.4 (G2), U21.2 (QC)
unnamed: U21.1 (QB), U25.2 (G1)
unnamed: U6.4 (G2), U21.6 (QG)
unnamed: U6.2 (G1), U21.7 (QH)
unnamed: U21.11 (SRCLK), U45.11 (SRCLK), U55.4 (Y)
unnamed: U21.12 (RCLK), U45.12 (RCLK), U54.4 (Y)
unnamed: U21.13 (~OE), U45.13 (~OE), U57.4 (Y)
unnamed: U21.14 (SER), U45.9 (QH')
unnamed: U21.15 (QA), U25.4 (G2)
unnamed: U22.1 (K), U23.6 (D1)
unnamed: U23.2 (G1), U29.19 (1Q)
unnamed: U23.3 (D2), U24.1 (K)
unnamed: U23.5 (G2), U29.18 (2Q)
unnamed: U26.1 (K), U27.6 (D1)
unnamed: U27.2 (G1), U29.17 (3Q)
unnamed: U27.3 (D2), U28.1 (K)
unnamed: U27.5 (G2), U29.16 (4Q)
unnamed: U29.12 (8Q), U35.5 (G2)
unnamed: U29.13 (7Q), U35.2 (G1)
unnamed: U29.14 (6Q), U31.5 (G2)
unnamed: U29.15 (5Q), U31.2 (G1)
unnamed: U30.1 (K), U31.6 (D1)
unnamed: U31.3 (D2), U32.1 (K)
unnamed: U33.2 (G1), U45.7 (QH)
unnamed: U33.4 (G2), U45.6 (QG)
unnamed: U34.1 (K), U35.6 (D1)
unnamed: U35.3 (D2), U36.1 (K)
unnamed: U37.1 (K), U39.6 (D1)
unnamed: U38.2 (G1), U45.5 (QF)
unnamed: U38.4 (G2), U45.4 (QE)
unnamed: U39.2 (G1), U44.19 (1Q)
unnamed: U39.3 (D2), U40.1 (K)
unnamed: U39.5 (G2), U44.18 (2Q)
unnamed: U41.1 (K), U42.6 (D1)
unnamed: U42.2 (G1), U44.17 (3Q)
unnamed: U42.3 (D2), U43.1 (K)
unnamed: U42.5 (G2), U44.16 (4Q)
unnamed: U44.12 (8Q), U51.5 (G2)
unnamed: U44.13 (7Q), U51.2 (G1)
unnamed: U44.14 (6Q), U48.5 (G2)
unnamed: U44.15 (5Q), U48.2 (G1)
unnamed: U45.1 (QB), U52.2 (G1)
unnamed: U45.2 (QC), U46.4 (G2)
unnamed: U45.3 (QD), U46.2 (G1)
unnamed: U45.14 (SER), U56.4 (Y)
unnamed: U45.15 (QA), U52.4 (G2)
unnamed: U47.1 (K), U48.6 (D1)
unnamed: U48.3 (D2), U49.1 (K)
unnamed: U50.1 (K), U51.6 (D1)
unnamed: U51.3 (D2), U53.1 (K)
U_PWR: C9.1, C11.1, U6.1 (S1), U6.3 (S2), U13.1 (S1), U13.3 (S2), U19.1 (S1), U19.3 (S2), U21.10 (~SRCLR), U21.16 (VCC), U25.1 (S1), U25.3 (S2), U33.1 (S1), U33.3 (S2), U38.1 (S1), U38.3 (S2), U45.10 (~SRCLR), U45.16 (VCC), U46.1 (S1), U46.3 (S2), U52.1 (S1), U52.3 (S2), U54.5 (VCC), U55.5 (VCC), U56.5 (VCC), U57.5 (VCC); also elsewhere on the board
VDD: C7.2, C8.2, C10.2, U12.20 (VCC), U29.20 (VCC), U44.20 (VCC), U54.1 (A), U55.1 (A), U56.1 (A), U57.1 (A); also elsewhere on the board

Notes on the sheet:
Level shifters

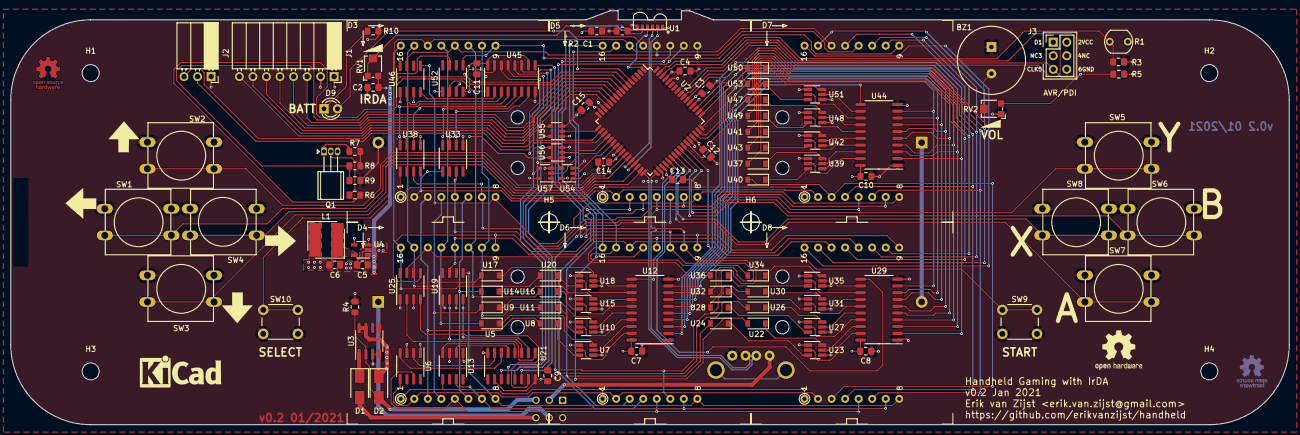
[picture p43: board handheld.kicad_pcb from above]

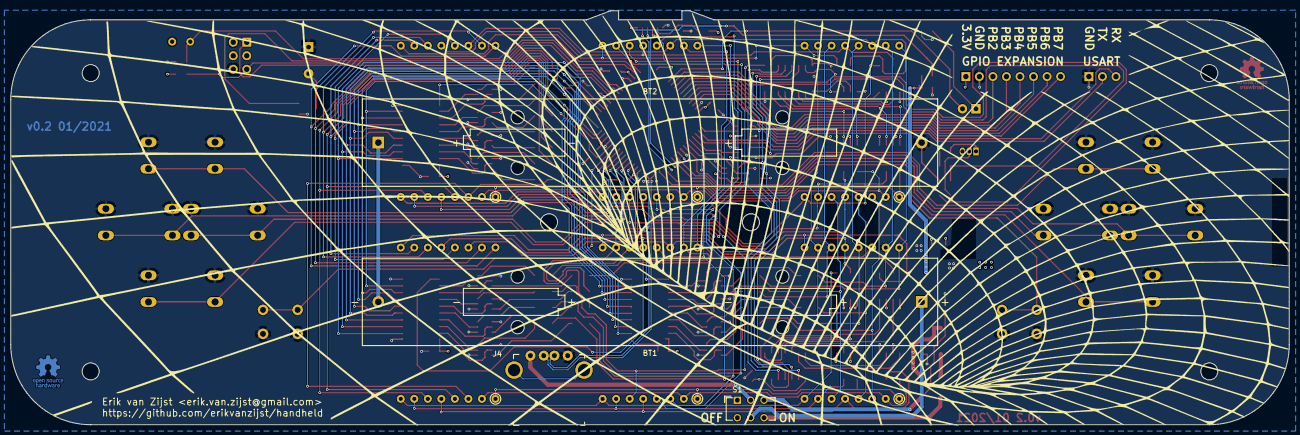
[picture p44: board handheld.kicad_pcb from below]

Board: 4 copper layers, 240.0 x 77.7 mm, 119 parts (4 on the bottom side), 171 nets.
