erikvanzijst/handheld/lv3273_shield/lv3273_shield.kicad_pcb

## KiCad design lv3273_shield/lv3273_shield.kicad_pcb (2021-01-18)

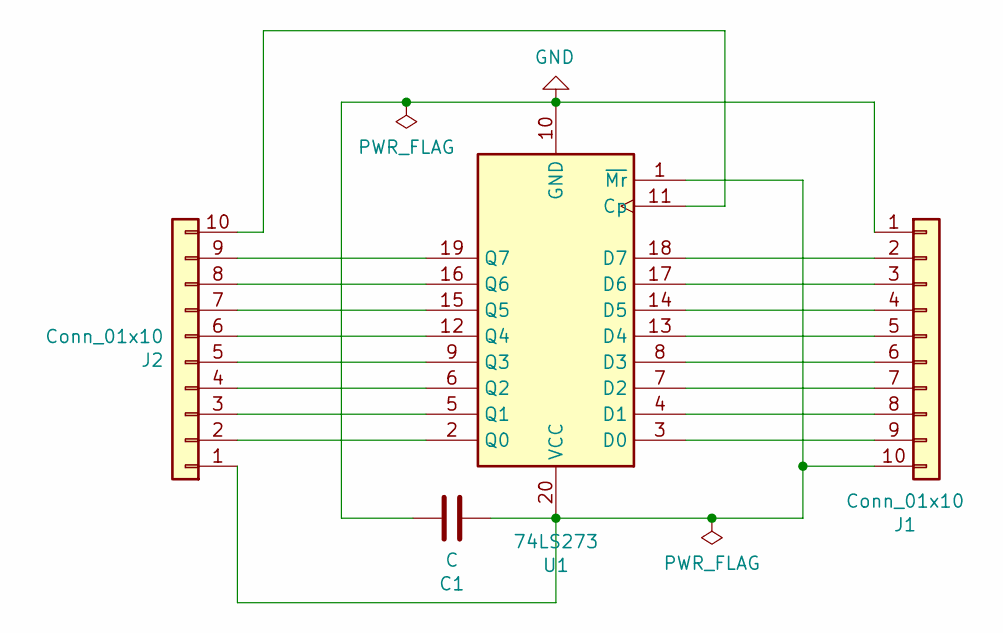
[picture p45: schematic lv3273_shield.sch]

Parts:
C1: C; C_0805_2012Metric
J1, J2: Conn_01x10; PinHeader_1x10_P1.00mm_Vertical
U1: 74LS273; SO-20_5.3x12.6mm_P1.27mm

Connections:
GND: C1.1, J1.1, U1.10 (GND)
unnamed: C1.2, J1.10, J2.1, U1.1 (~Mr), U1.20 (VCC)
unnamed: J1.2, U1.18 (D7)
unnamed: J1.3, U1.17 (D6)
unnamed: J1.4, U1.14 (D5)
unnamed: J1.5, U1.13 (D4)
unnamed: J1.6, U1.8 (D3)
unnamed: J1.7, U1.7 (D2)
unnamed: J1.8, U1.4 (D1)
unnamed: J1.9, U1.3 (D0)
unnamed: J2.2, U1.2 (Q0)
unnamed: J2.3, U1.5 (Q1)
unnamed: J2.4, U1.6 (Q2)
unnamed: J2.5, U1.9 (Q3)
unnamed: J2.6, U1.12 (Q4)
unnamed: J2.7, U1.15 (Q5)
unnamed: J2.8, U1.16 (Q6)
unnamed: J2.9, U1.19 (Q7)
unnamed: J2.10, U1.11 (Cp)

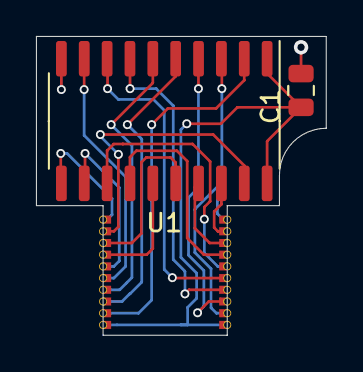
[picture p46: board lv3273_shield.kicad_pcb from above]

Board: 2 copper layers, 16.1 x 16.6 mm, 4 parts (0 on the bottom side), 19 nets.
