erikvanzijst/handheld/firmware/main.c

/*
MIT License

Copyright (c) 2022 Erik van Zijst <erik.van.zijst@gmail.com>

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
THE SOFTWARE IS PROVIDED "AS IS", WITHOUT WARRANTY OF ANY KIND, EXPRESS OR
IMPLIED, INCLUDING BUT NOT LIMITED TO THE WARRANTIES OF MERCHANTABILITY,
FITNESS FOR A PARTICULAR PURPOSE AND NONINFRINGEMENT. IN NO EVENT SHALL THE
AUTHORS OR COPYRIGHT HOLDERS BE LIABLE FOR ANY CLAIM, DAMAGES OR OTHER
LIABILITY, WHETHER IN AN ACTION OF CONTRACT, TORT OR OTHERWISE, ARISING FROM,
OUT OF OR IN CONNECTION WITH THE SOFTWARE OR THE USE OR OTHER DEALINGS IN THE
SOFTWARE.
*/
#include <atmel_start.h>
#include <stdio.h>
#include <font.h>
#include <wallclock.h>
#include <screen.h>
#include <util.h>
#include "1player.h"
#include "2player.h"
#include "button.h"

int main(void)
{
	/* Initializes MCU, drivers and middleware */
	atmel_start_init();
    OEB_set_level(false);

    clear_screen();
    printf("Tetris firmware build: %s\r\n", VERSION_STR);
    printf("https://github.com/erikvanzijst/handheld\r\n");
    printf("Erik van Zijst <erik.van.zijst@gmail.com>\r\n\r\n");
    scroll("TETRIS      ", "", -1);
    srand((unsigned int)millis());  // use human button press delay as random seed

    while (true) {
        printf("Game type selection screen.\r\n");
        clear_screen();
        button_t * button = scroll("A:1p  ", "B:2p  ", -1);

        if (button == &btn_a) {
            printf("Launching single player mode...\r\n");
            while(true) single_player();
        } else if (button == &btn_b) {
            printf("Launching multiplayer mode...\r\n");
            while(true) multi_player();
        } else {
            printf("Invalid selection\r\n");
        }
    }
}
