erikvanzijst/handheld/firmware/src/sound.c

/*
MIT License

Copyright (c) 2022 Erik van Zijst <erik.van.zijst@gmail.com>

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
THE SOFTWARE IS PROVIDED "AS IS", WITHOUT WARRANTY OF ANY KIND, EXPRESS OR
IMPLIED, INCLUDING BUT NOT LIMITED TO THE WARRANTIES OF MERCHANTABILITY,
FITNESS FOR A PARTICULAR PURPOSE AND NONINFRINGEMENT. IN NO EVENT SHALL THE
AUTHORS OR COPYRIGHT HOLDERS BE LIABLE FOR ANY CLAIM, DAMAGES OR OTHER
LIABILITY, WHETHER IN AN ACTION OF CONTRACT, TORT OR OTHERWISE, ARISING FROM,
OUT OF OR IN CONNECTION WITH THE SOFTWARE OR THE USE OR OTHER DEALINGS IN THE
SOFTWARE.
*/
#include <atmel_start_pins.h>
#include <compiler.h>
#include <stdint.h>
#include <stdio.h>
#include "sound.h"

bool sound_enabled = true;

typedef struct {
    uint8_t prescalar;          // timer prescalar
    uint16_t period;            // timer period
    int32_t toggle_count;       // total duration
    int32_t toggle_remaining;   // -1 for indefinitely
} tone_t;

typedef struct {
    melody_t *melody;
    /*
     * The next note to be played `(0 <= current_note < .melody->len)`.
     */
    uint16_t current_note;
    int16_t remaining;          // -1 for indefinitely
} running_melody_t;

running_melody_t curr_melody = {
    .melody = NULL,
    .current_note = 0
};
tone_t curr_tone;

/*
 * Starts `curr_melody`'s current note (`curr_melody->current_note`).
 */
void play_next_note() {
    // queue the next tone
    uint16_t wholenote = (60000 * 4) / curr_melody.melody->tempo;
    uint32_t duration = 0;

    int16_t frequency = curr_melody.melody->notes[curr_melody.current_note * 2];
    int16_t divider = curr_melody.melody->notes[curr_melody.current_note * 2 + 1];

    if (divider > 0) {
        // regular note, just proceed
        duration = wholenote / divider;
    }
    else if (divider < 0) {
        // dotted notes are represented with negative durations!
        duration = wholenote / abs(divider);
        duration *= 1.5; // increases the duration in half for dotted notes
    }

    uint8_t prescalar = TC_CLKSEL_DIV1_gc;
    uint32_t period = F_CPU / frequency / 2 - 1;

    if (period > 0xffff) {
        prescalar = TC_CLKSEL_DIV64_gc;
        period = F_CPU / frequency / 2 / 64 - 1;
    }

    if (duration > 0) {
        curr_tone.toggle_count = curr_tone.toggle_remaining = 2 * frequency * duration / 1000;
    } else {
        curr_tone.toggle_count = curr_tone.toggle_remaining = -1;
    }
    TCC1.CTRLA = prescalar;
    TCC1.PER = period;

    // printf("Staring new tone %uHz, %ums\r\n", frequency, duration);
}

int play_melody(melody_t *melody, int16_t repeat) {
    if (melody->len < 1) {
        printf("WARNING: Ignoring zero-length melody\r\n");
        return -1;
    }
    else {
        stop_melody();
        curr_melody.melody = melody;
        curr_melody.current_note = 0;
        curr_melody.remaining = (repeat <= 0 ? -1 : repeat);
        play_next_note();
    }
    return 0;
}

void stop_melody() {
    curr_tone.toggle_remaining = -1;
    TCC1.CTRLA = TC_CLKSEL_OFF_gc;
}

bool is_muted() {
    return !sound_enabled;
}

void mute(bool muted) {
    sound_enabled = !muted;
}

void tone_isr() {
    if (sound_enabled) {
        if (curr_tone.toggle_remaining != 0) {
            if (curr_tone.toggle_remaining < curr_tone.toggle_count * 0.9) {
                // be quiet for the last 10% of note duration
                BUZZER_toggle_level();
            }
            curr_tone.toggle_remaining--;
        }
        else {
            // queue the next tone
            curr_melody.current_note = (curr_melody.current_note + 1) % curr_melody.melody->len;
            if (curr_melody.current_note == 0 && curr_melody.remaining > 0) {
                curr_melody.remaining--;
                printf("Melody finished (%d loops remaining).\r\n", curr_melody.remaining);
            }
            if (curr_melody.remaining != 0) {
                play_next_note();
            } else {
                printf("Melody loop finished.\r\n");
                stop_melody();
            }
        }
    }
}
