erikvanzijst/handheld/(commit log)

2020-07-25 Initial commit
    Carrying over the custom matrix display design as starting point.
    [matrix.kicad_pcb, matrix.sch]
2020-07-26 Renamed KiCad project
    [handheld.kicad_pcb, handheld.sch]
2020-07-27 Working on schematic
    [handheld.sch]
2020-08-03 Add datasheets for buck converter and trimmer pot
    [handheld.sch]
2020-08-03 Add power sheet
    [power.sch]
2020-08-23 Move displays to separate sheet
    [handheld.sch, matrix.sch, power.sch]
2020-08-24 Clean up DRC errors and buses
    [handheld.sch, matrix.sch, power.sch]
2020-10-12 Change column control to 8 bit bus
    [handheld.sch, power.sch]
2020-10-12 Finishes matrix driver circuit
    [TC-33X-2.stp, handheld.sch, matrix.sch, power.sch]
2020-10-13 Switches to ATXMEGA64C3 for USB
    [handheld.sch, power.sch]
2020-10-13 Adds IrDA transceiver
    [84406TFBS4711.stp, handheld.sch, power.sch]
2020-10-13 Adds footprint for IrDA module
2020-10-13 Adds power switch
    [power.sch]
2020-10-13 Adds piezo buzzer
    [handheld.sch]
2020-10-14 Adds GPIO expansion port
    [handheld.sch, power.sch]
2020-10-14 Adds AA battery holders
    [handheld.sch, power.sch]
2020-10-15 Adds AVR/PDI header footprint
    [handheld.sch, power.sch]
2020-10-15 Adds inductor datasheet
    [power.sch]
2020-10-15 Adds inductor footprint
    [power.sch]
2020-10-15 Fixes footprints
    [handheld.kicad_pcb, handheld.sch]
2020-10-16 Switches battery holders and adds switch footprint
    [power.sch]
2020-10-16 Adds board outline
    [power.sch]
2020-10-17 Starts matrix driver component layout
    [matrix_driver.sch, power.sch]
2020-10-17 Adds column drivers
    [handheld.kicad_pcb, handheld.sch]
2020-10-18 First stab at constant current drivers
    [handheld.kicad_pcb]
2020-10-18 Adds more constant current drivers
    [handheld.kicad_pcb]
2020-10-18 Adds more column circuitry
    [handheld.kicad_pcb]
2020-10-19 Wires up USB and buttons
    [handheld.kicad_pcb]
2020-11-22 Added power plane and reassigned pinout
    [handheld.kicad_pcb, handheld.sch, power.sch]
2020-11-23 Wired up buzzer and LDR
    [handheld.kicad_pcb, handheld.sch, power.sch]
2020-11-23 Places rectifiers
    [handheld.kicad_pcb]
2020-11-27 Added power net and buck converter
    Also wired up Ir transceiver.
    [handheld.kicad_pcb, handheld.sch, power.sch]
2020-11-27 Added GPIO expansion header
    [handheld.kicad_pcb, handheld.sch]
2020-11-27 Add ATMEGA schematic checklist doc
2020-11-28 Decouple microcontroller
    [handheld.kicad_pcb, handheld.sch, power.sch]
2020-11-28 Add 3D models
    [B3F-4055--3DModel-STEP-273799.STEP, handheld.kicad_pcb]
2020-11-29 Adds SELECT button
    [handheld.kicad_pcb, handheld.sch]
2020-11-29 Adds Bourns TC33X 3D model
    [TC33X-2-202E--3DModel-STEP-56544.step, handheld.kicad_pcb]
2020-11-30 Adding level shifters
    [handheld.kicad_pcb, handheld.sch, matrix_driver.sch, power.sch]
2020-12-13 Wired up battery level check
    [handheld.kicad_pcb, handheld.sch, matrix_driver.sch]
2020-12-13 Added mounting holes
    [handheld.kicad_pcb]
2020-12-14 Add silkscreen art and version
    [handheld.kicad_pcb]
2020-12-14 Add logos
    [handheld.kicad_pcb]
2020-12-21 Fix register footprints and add batt indicator
    [handheld.kicad_pcb, handheld.sch, matrix_driver.sch, power.sch]
2020-12-21 Switched to registers with clear
    Also added the mountng holes as annotated symbols with footprints.
    [handheld.kicad_pcb, handheld.sch, matrix_driver.sch]
2020-12-22 Add silkscreen art
    [handheld.kicad_pcb]
2020-12-22 Reduce pad with for SSOP-20 footprint
    This ensures there's solder mask between the pads.
    [handheld.kicad_pcb, handheld.sch, matrix_driver.sch]
2020-12-22 Completed v0.1
    [handheld-B_Mask.gbr, handheld-B_SilkS.gbr, handheld-Back.gbr, handheld-Edge_Cuts.gbr, handheld-F_Mask.gbr, handheld-F_Paste.gbr, handheld-F_SilkS.gbr, handheld-Front.gbr]
2020-12-23 Fix UPWR/GND short circuit on front copper
    Caught a zone priority error that caused power and ground pours
    to overlap and short circuit.
    Unfortunately the board is already being fabricated and so this
    will have to be bodged on v0.1.
    [handheld-B_Mask.gbr, handheld-B_SilkS.gbr, handheld-Back.gbr, handheld-Edge_Cuts.gbr, handheld-F_Mask.gbr, handheld-F_Paste.gbr, handheld-F_SilkS.gbr, handheld-Front.gbr]
2020-12-29 Fix solder mask margins and named programming nets
    [handheld.kicad_pcb, handheld.sch]
2021-01-17 Add pin assignments
2021-01-17 Disable display bus due to footprint error
    The footprint of the 74LV273 octal flip-flop is wrong and doesn't
    match that of the actual chip. As a result, the flip-flops cannot
    be used and the bus must be set to high impedance for now.
    Next step might be an adaptor board that can be soldered on top of
    the footprint.
    [driver_init.c, main.c]
2021-01-17 Disconnect USB shield from ground plane
    Also Fixed obscured refdes indicators.
    [handheld.kicad_pcb, handheld.sch, power.sch]
2021-01-17 Document power/gnd plane short circuit bug
2021-01-17 Draw outlines for 74lv273 castellated shield
    [handheld.kicad_pcb]
2021-01-18 Adds errata shield PCB for messed up SSOP-20 pinout
    [handheld.kicad_pcb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]
2021-01-18 Remove shield measurements
    [handheld.kicad_pcb]
2021-01-18 Swith back to 74LV573 flip-flop
    This changes switches back to the original 74LV573 octal flip-flop
    instead of the 273. This due to the pinout difference and the fact
    that the board already followed the pinout of th 573.
    Package is still SSOP-20.
    [matrix_driver.sch]
2021-01-19 Switched back to SOIC-20 package for the 74LV573s
    Because they're easier to solder and we've got enough space.
    [handheld.kicad_pcb, matrix_driver.sch]
2021-01-24 Testing column circuitry
2021-01-25 Adding timer and interrupt vector
2021-01-31 Enabling the screen redraw interrupt vector
2021-01-31 Add USART on external board header
    Prints out the location of the bouncy ball on the UART in real time.
2021-01-31 Add a millis() function to return millis since boot
2021-02-01 Add button polling and debouncing
2021-02-03 Add button definitions
    Also set random seed from human button press delay.
2021-02-15 Add sound and melody driver
    Also adds the Tetris and Super Mario melodies.
2021-02-15 Add game over tune when you die
2021-02-15 Select button mutes sound
2021-02-15 Add a hold section
    Pressing UP now switches the current tetromino with the one in the
    hold section on the top left. Only one swap is allowed per brick.
    [tetris.c]
2022-03-06 Add alarm function
    To be used in future IrDA wire protocol.
2022-03-06 First attempt at UART over IRCOMM and IrDA
2022-03-06 Added logic analyzer images of Ir UART traffic
2022-03-13 Publish # lines removed in each packet
    This will allow us to add the peer's lines to our board.
2022-03-16 Move irda_write to ISR and scroll end screen
    Now publishing the IrDA packets from the new, second alarm
    interrupt, freeing up the main loop to scroll the text on the end
    screen.
2022-03-16 Fixed display corruption in right hand board
    [1player.c, 2player.c, tetris.c, tetris.h]
2022-03-17 Fix deadlock bug in reconnect logic
    When the connection was lost in one direction and while it's down
    one player dies, then the synchronization would deadlock upon
    reconnection.
    [2player.c]
2022-03-21 Fix bug with insertion of penalty lines
    [2player.c, tetris.c, tetris.h]
